LasCazas/SimulacaoHil/Assets/volante_clean.png

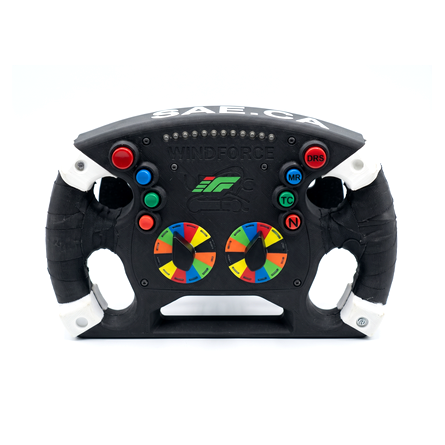
Assets/volante_clean.png
